ThomasZehnder/ShuntDelayByPass/20250421_schema.jpg

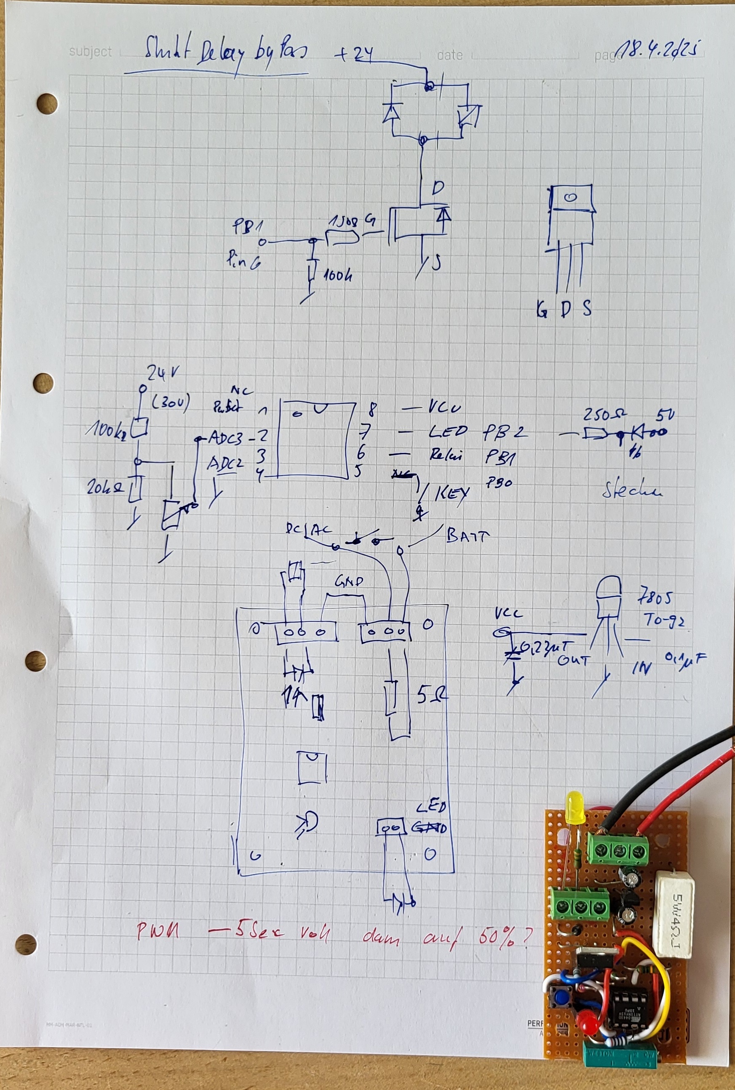
20250421_schema.jpg
