ThomasZehnder/ShuntDelayByPass/(commit log)

2025-04-19 move in folder to be used for ARDUINO Studio
2025-04-19 probleme mit zwei adc read noch offen
    [ShuntDelayBypass.ino]
2025-04-20 new statemachine with key handling (Reference voltage still fix)
    [ShuntDelayBypass.ino]
2025-04-20 store reference voltage works
2025-04-20 reduce relais voltage to 25% PWM
2025-04-30 observe on low voltage to restart switch on process
2025-05-03 Bei 80% der Spannung wird das relais voll eingeschaltet. 1 Sekunde laden, dann 3 Sekunden warten bis Relais schaltet.
2025-05-04 define to configure without pwm
